RomiFC/RF-DFS/PCB/_dependencies/3dmodels/PMA-183PLN+.stp

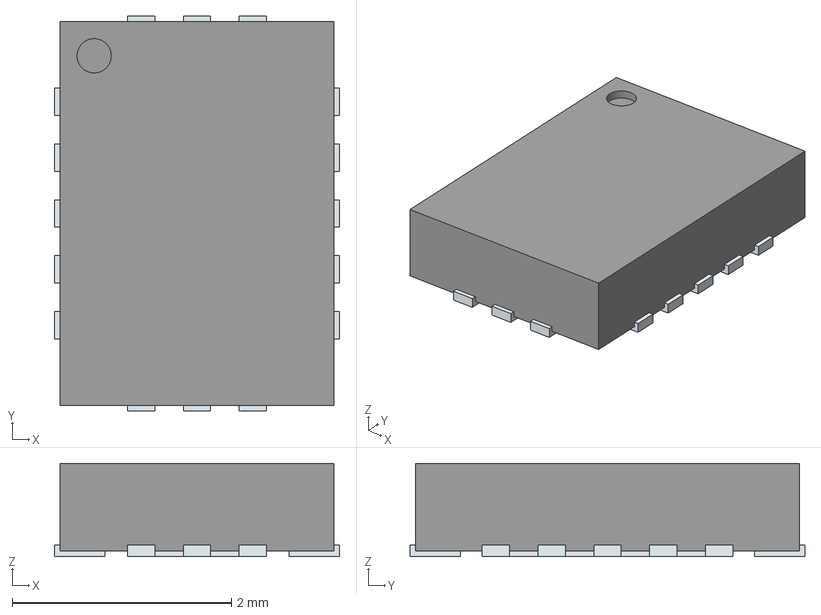
[picture p1: CAD file, 2024-10-30]
PCB/_dependencies/3dmodels/PMA-183PLN+.stp
2.60 x 3.60 x 0.85 mm
ThermalPin
PinsArrayLR
PinsArrayTB
