RomiFC/RF-DFS/PCB/_dependencies/3dmodels/TSS-183A+.stp

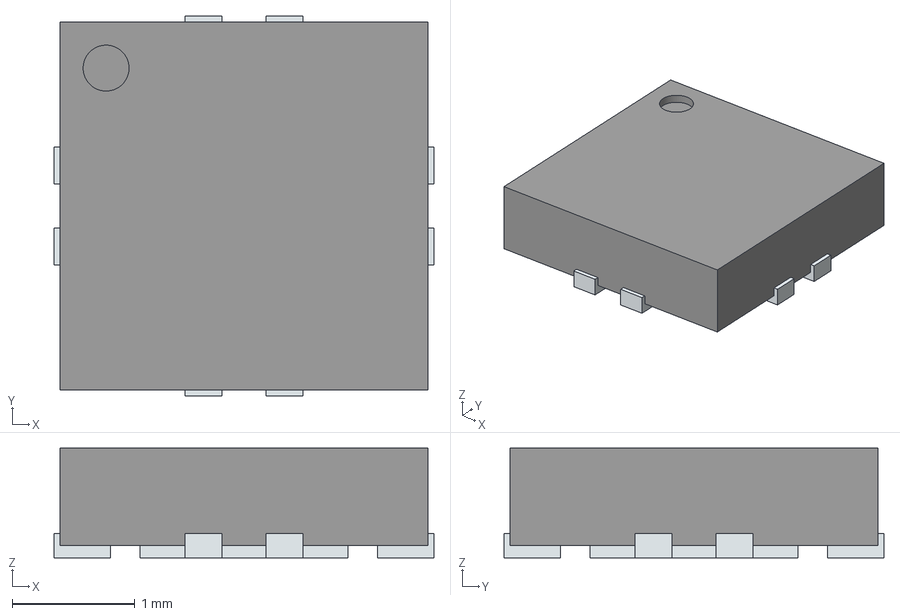
[picture p2: CAD file, 2024-10-30]
PCB/_dependencies/3dmodels/TSS-183A+.stp
3.10 x 3.10 x 0.894 mm
ThermalPin
PinsArrayLR
PinsArrayTB
