RomiFC/RF-DFS/PCB/_dependencies/3dmodels/ADL5902-EVALZ.step

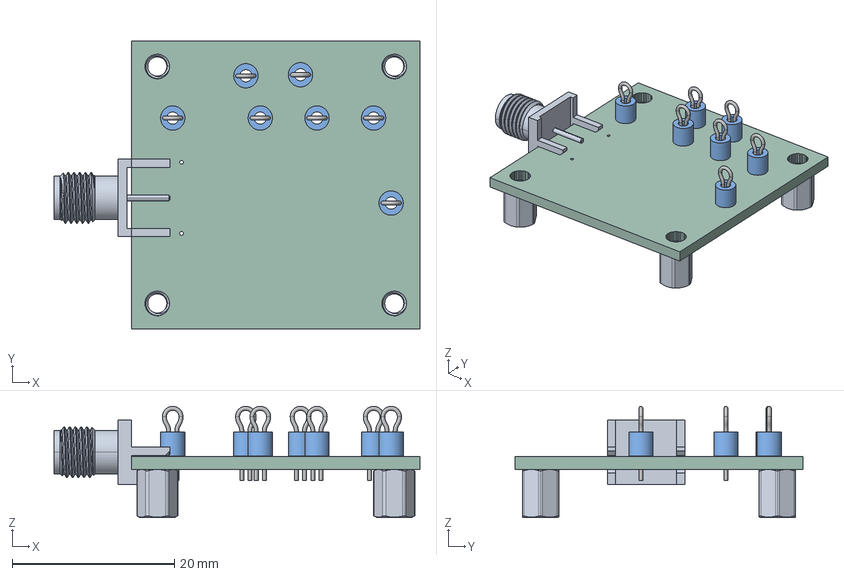
[picture p3: CAD file, 2024-10-30]
PCB/_dependencies/3dmodels/ADL5902-EVALZ.step
45.1 x 35.6 x 13.7 mm
ADL5902-EVALZ PCB
