RomiFC/RF-DFS/PCB/_dependencies/3dmodels/PMA3-14LN+.stp

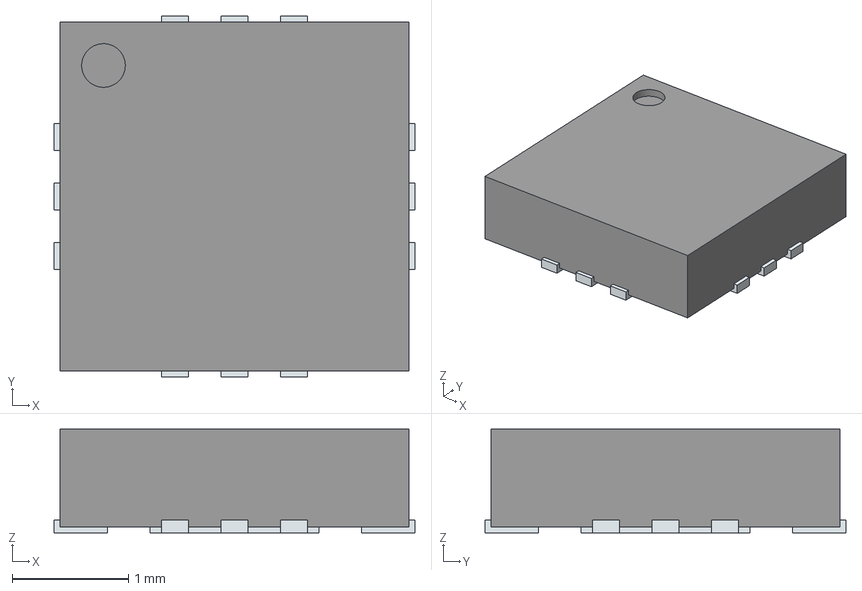
[picture p4: CAD file, 2024-10-30]
PCB/_dependencies/3dmodels/PMA3-14LN+.stp
3.10 x 3.10 x 0.89 mm
ThermalPin
PinsArrayLR
PinsArrayTB
