RomiFC/RF-DFS/PCB/_dependencies/3dmodels/73251-1153.stp

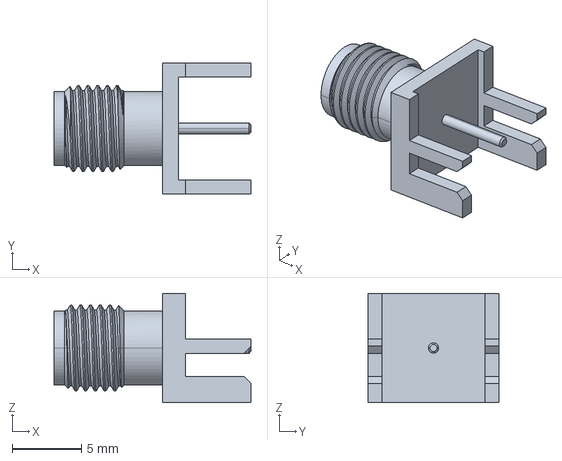
[picture p5: CAD file, 2024-10-30]
PCB/_dependencies/3dmodels/73251-1153.stp
14.3 x 9.53 x 7.92 mm
