RomiFC/RF-DFS/User Guide/README.md

# LaTeX Template

Package fontspec requires XeLaTeX or LuaTeX to compile. If using LaTeX Workshop with VSCode, add `"latex-workshop.latex.recipe.default": "latexmk (xelatex)"` to `workspace.json` or `settings.json`
