RomiFC/RF-DFS/(threads)

Thread 8 (2025-07-18):

Implement trace types

RomiFC, 2025-07-18:
Clear/write is currently the only supported trace type although max hold and average would probably be the most used. This feature should also include the parameters for each trace type (avg count, reset hold, etc.).

Closed 2025-08-06.

Thread 13 (2025-07-19):

Add a method to query spectrum analyzer errors/warnings

RomiFC, 2025-07-19:
An active panel to show errors and warnings like the one on the bottom of the N9040B interface. Some of the errors appear very quickly (ADC overload when the repeater is keyed up) so they need to be queried more often than the SA sweeps.

Thread 14 (2025-07-24):

Add pictures to the user guide

RomiFC, 2025-07-24:
Self explanatory. The ones taken for the DRIFT _about_ page will work fine, also include some pictures of the panels where the electronics are mounted to.

RomiFC, 2025-08-11:
Pictures of the panels can be added at a later date

Thread 18 (2025-08-06):

Streamline single/continuous sweep state machines

RomiFC, 2025-08-06:
Since #17 separates the measurement into INIT and FETCH, :INIT:CONT ON|OFF can be used instead of a Python state machine to keep track of single/continuous sweep states

RomiFC, 2025-08-06:
See also INIT:IMMEDIATE for a _Restart_ button

RomiFC, 2025-08-06:
Should implement a way for single to initiate a sweep if already in single mode (at the moment INIT:CONT 0 does nothing if already in single mode).

Closed 2025-08-06.

Thread 23 (2025-08-11):

Add "Config" section to user guide

RomiFC, 2025-08-11:
Describe `defaultconfig.py` and motor encoder calibration or separate that into another section.

Thread 24 (2025-08-12):

Automation rework

RomiFC, 2025-08-12:
Add an entry widget to the automation queue, allowing users to write python code for each automation thread. More complicated, more potential for things to break, but allows users to do more things.

Need some way to test if a job is active before starting another because if multiple jobs try to access a resource it will surely break things. Also need to disable spectrum analyzer/bearing widgets while the job scheduler is active.

Add some preset job examples for the user to reference in the program.

Closed 2025-08-13.

Thread 26 (2025-08-14):

Consider adding parameter for single/continuous mode

RomiFC, 2025-08-14:
Currently, `analyzerDisplayLoop` attempts to query the spectrum analyzer and populate the front panel in a perpetual `while True:` loop. A problem arises when trying to access the SA front panel because every command will lock it into remote mode.

A benefit of this would be that `analyzerDisplayLoop` could update another widget to display if the device is in single or continuous mode as it would already be querying the local variable before trying to access the resource.

Regardless, Section 3.1 of the documentation needs revision to accurately depict what is happening in `analyzerDisplayLoop`.
