RomiFC/RF-DFS/PCB/PMA3-14LN+/PMA3-14LN+__Assembly.pdf

1 | 2 | 3 | 4 | 5

A

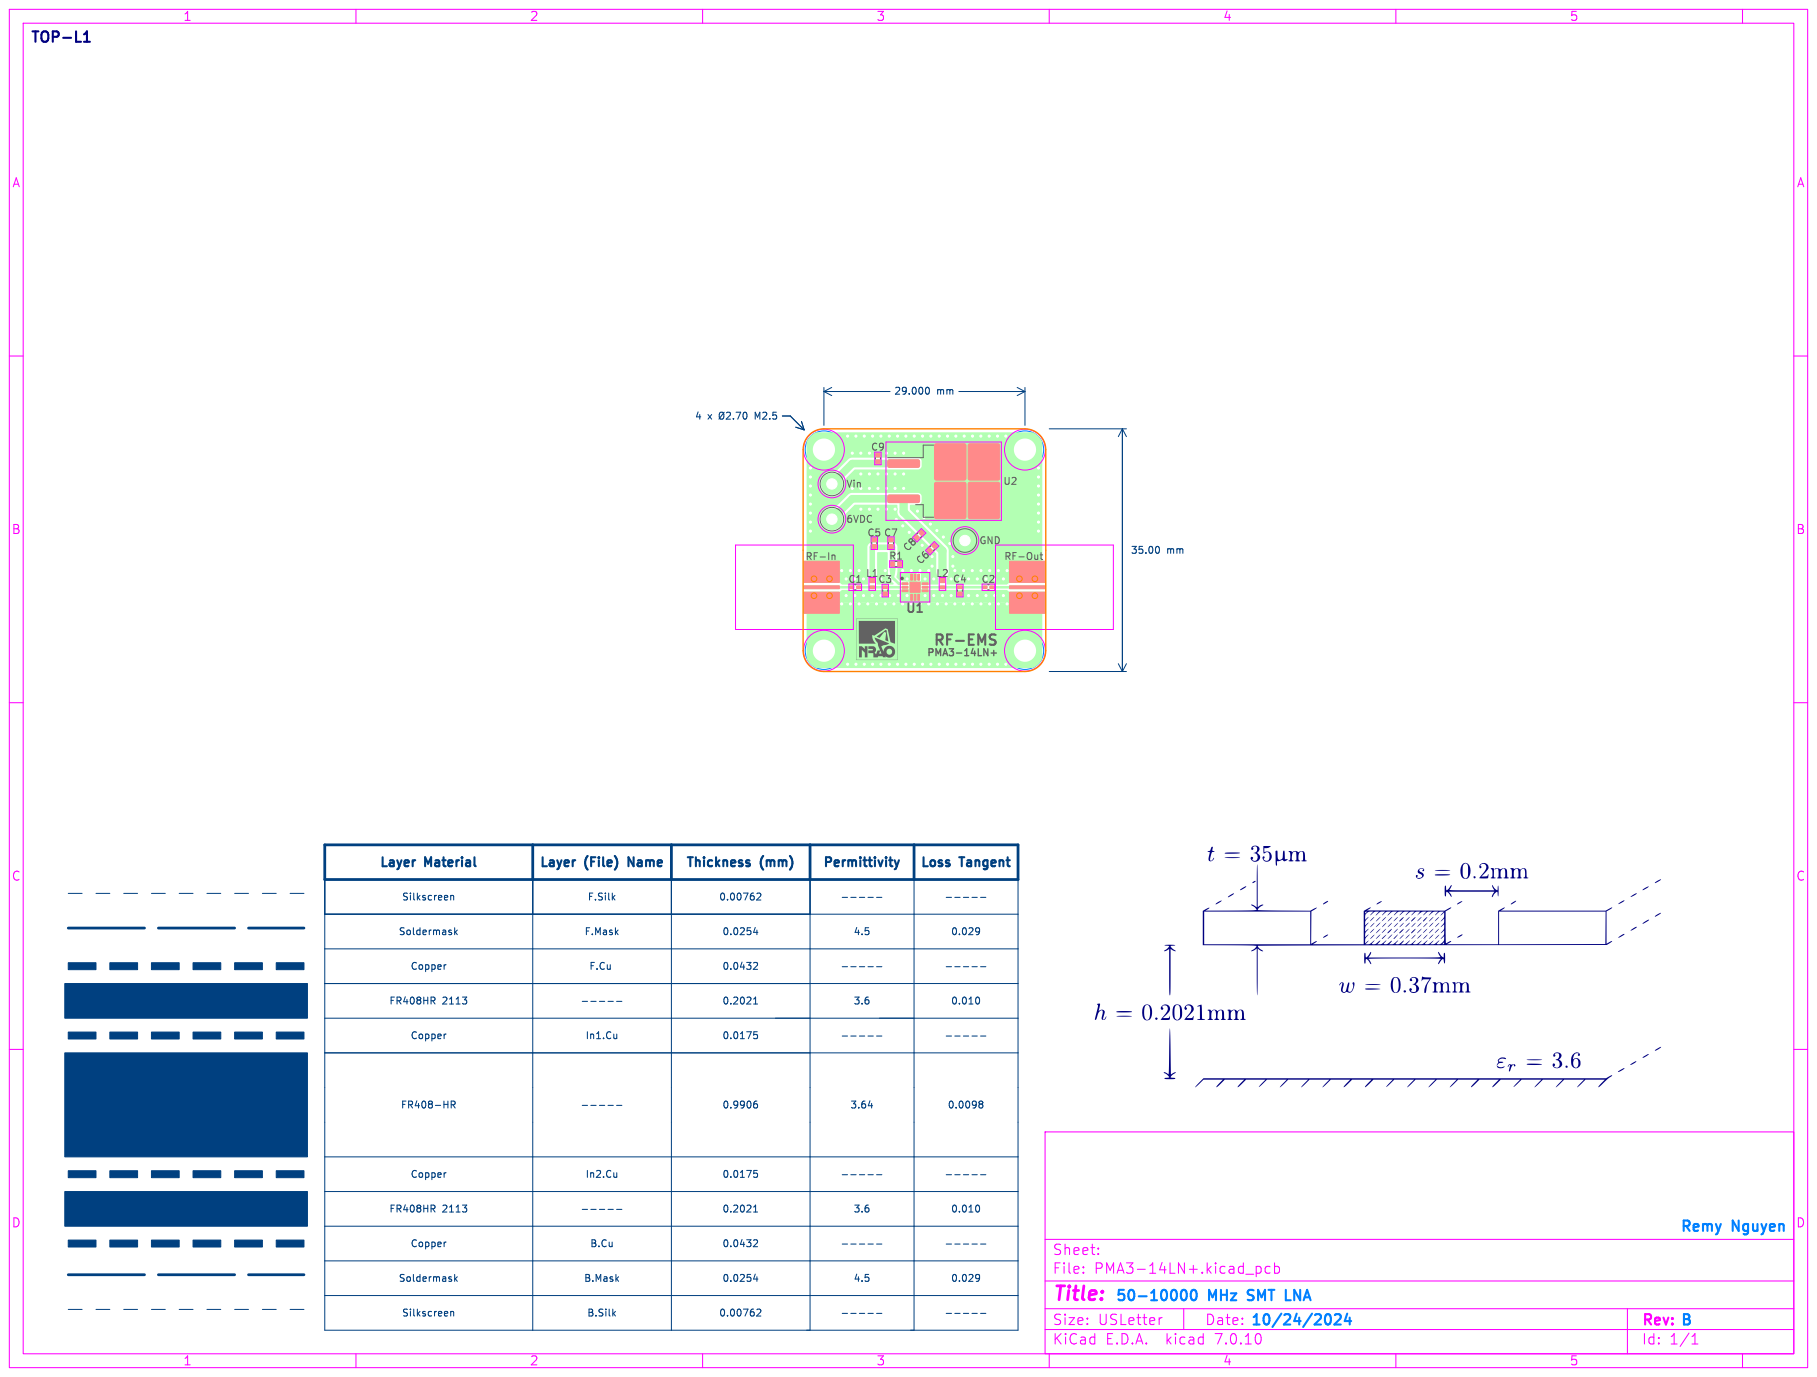
[picture p10: page 1]

Id: 1/1 Title: File: PMA3-14LN+.kicad_pcb Sheet: RF-EMS

A

A

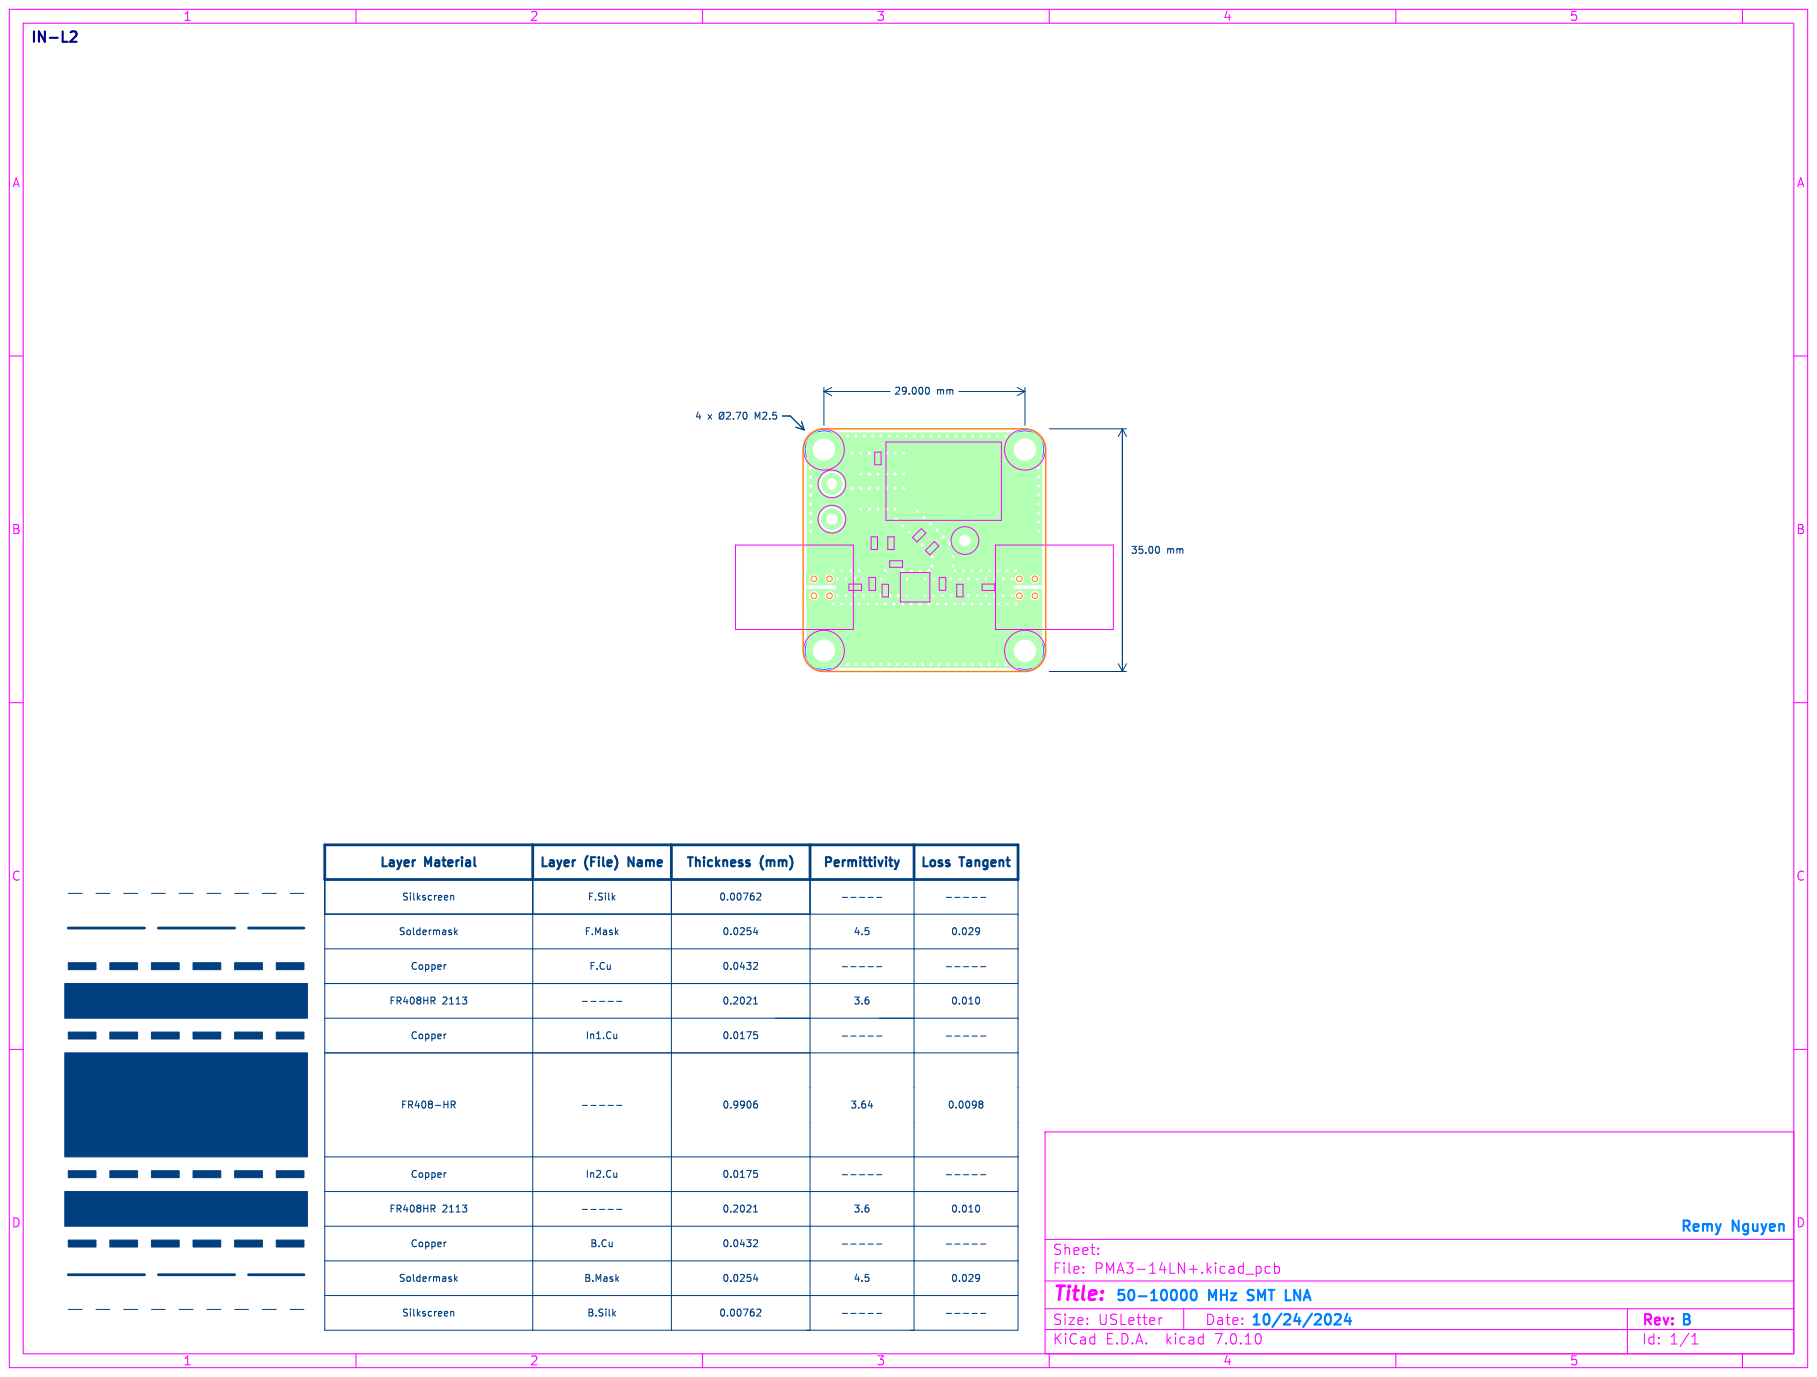
[picture p11: page 2]
Remy; Nguyen; MHz SMT; LNA; D Date: KiCad; kicad; 7.0.10 Size: USLetter; Rev:

-----F.Cu | 0.2021 Layer Material (mm) | Permittivity ----- Thickness ----- | ----- Loss Tangent Copper

Name F.Mask | 0.00762 Copper 0.0175 | ----- Layer (File) ----- F.Silk | 0.010 Soldermask ----- 3.6

Copper | In1.Cu | 0.0175 | ----- Soldermask | ----- Silkscreen FR408HR 2113

---------- | 0.0432 B.Cu 0.0432 FR408-HR | 3.64 ----- Copper | ----- 0.0254 0.0098

In2.Cu | 0.9906 Silkscreen

0.2021 B.Silk | 3.6 B.Mask

Id: 1/1 Title: File: PMA3-14LN+.kicad_pcb Sheet:

A

A

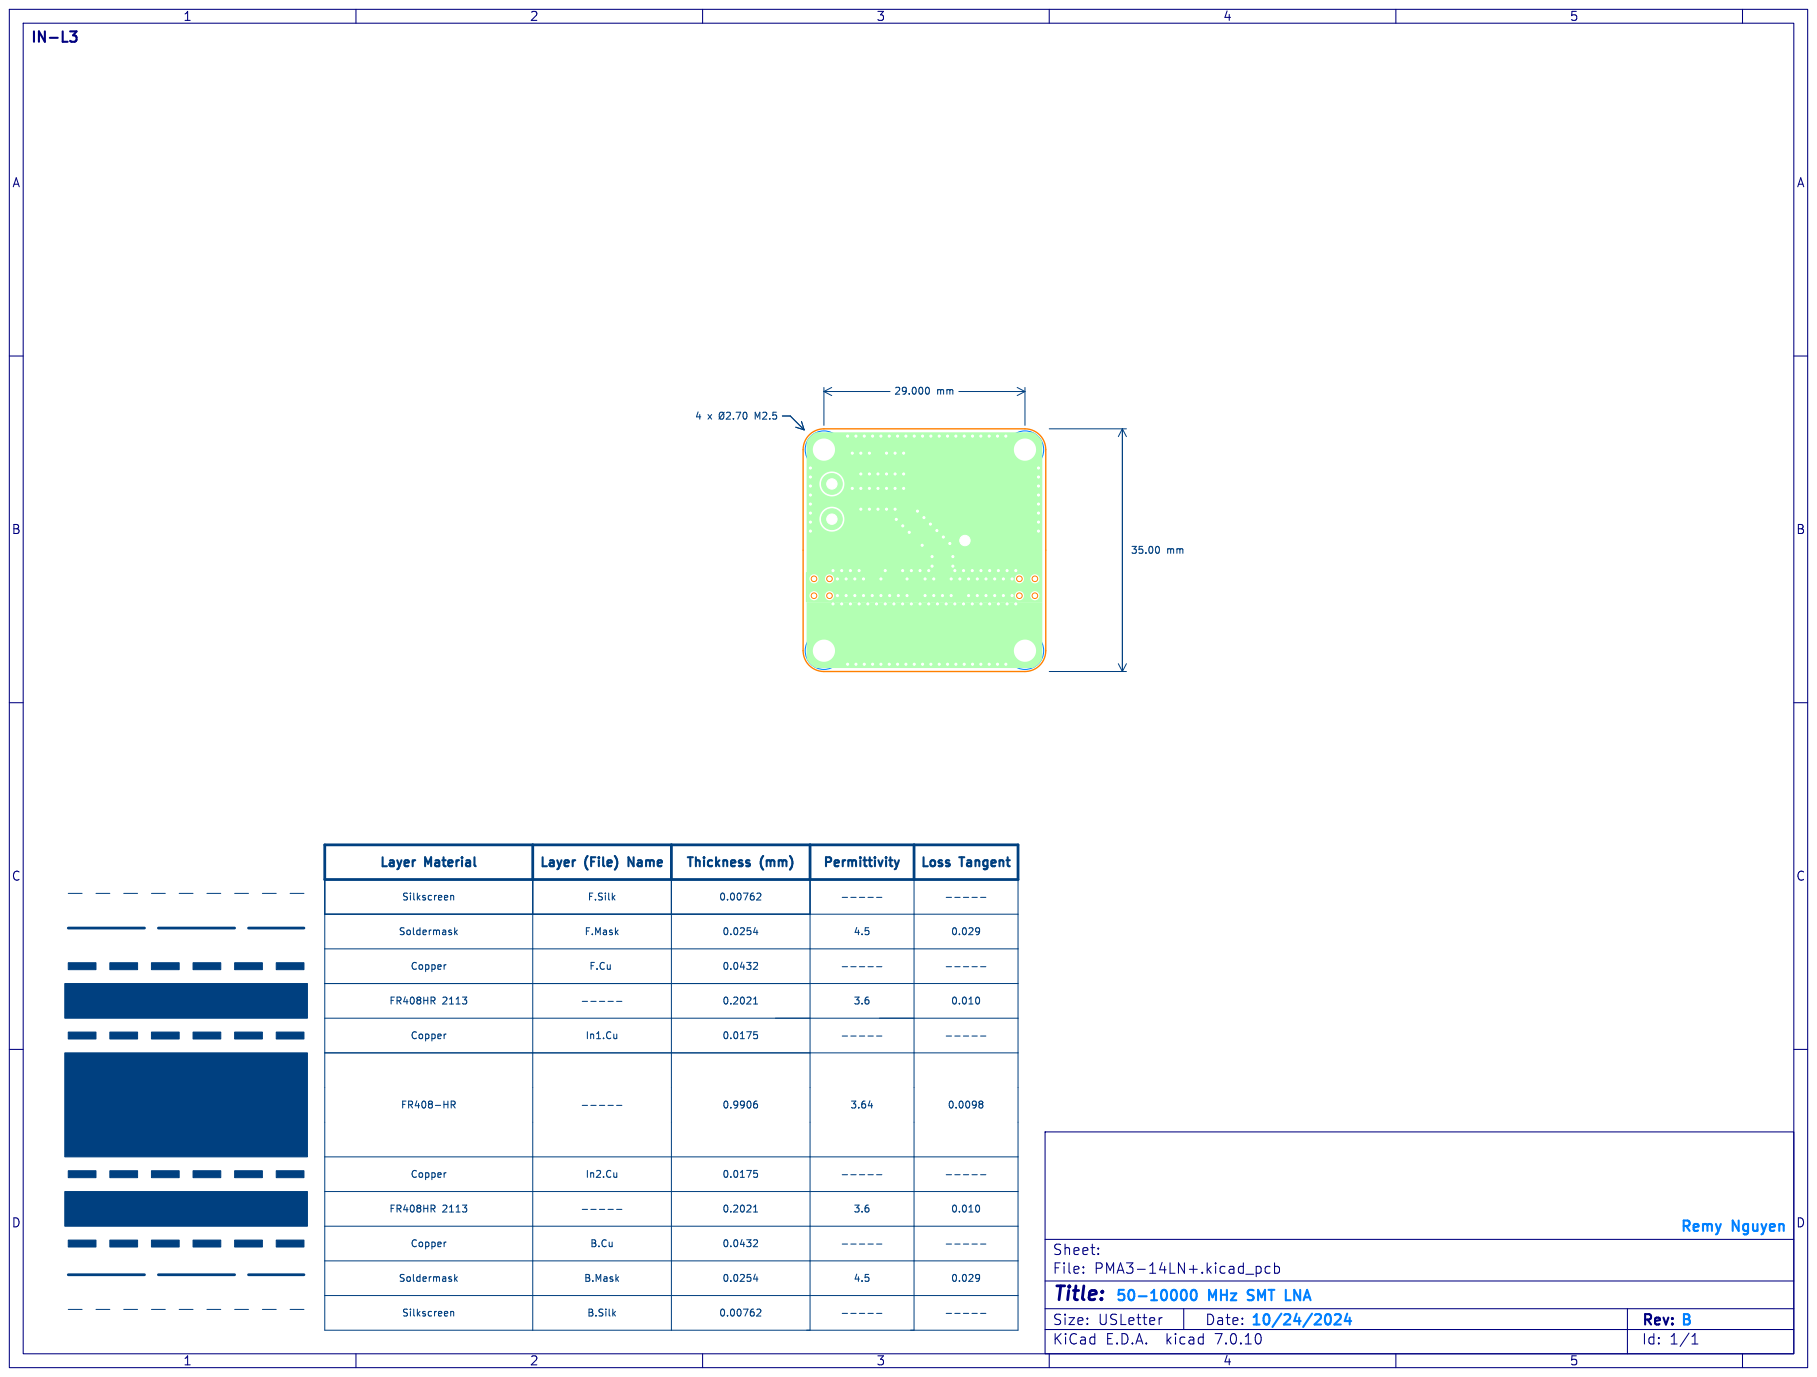
[picture p12: page 3]
Remy; Nguyen; MHz SMT; LNA; D Date: KiCad; kicad; 7.0.10 Size: USLetter; Rev:

-----F.Cu | 0.2021 Layer Material (mm) | Permittivity ----- Thickness ----- | ----- Loss Tangent Copper

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

Copper | In1.Cu | 0.0175 | ----- Soldermask | ----- Silkscreen FR408HR 2113

---------- | 0.0432 B.Cu 0.0432 FR408-HR | 3.64 ----- Copper | ----- 0.0254 0.0098

In2.Cu | 0.9906 Silkscreen

0.2021 B.Silk | 3.6 B.Mask

Id: 1/1 Title: File: PMA3-14LN+.kicad_pcb Sheet:

A

A

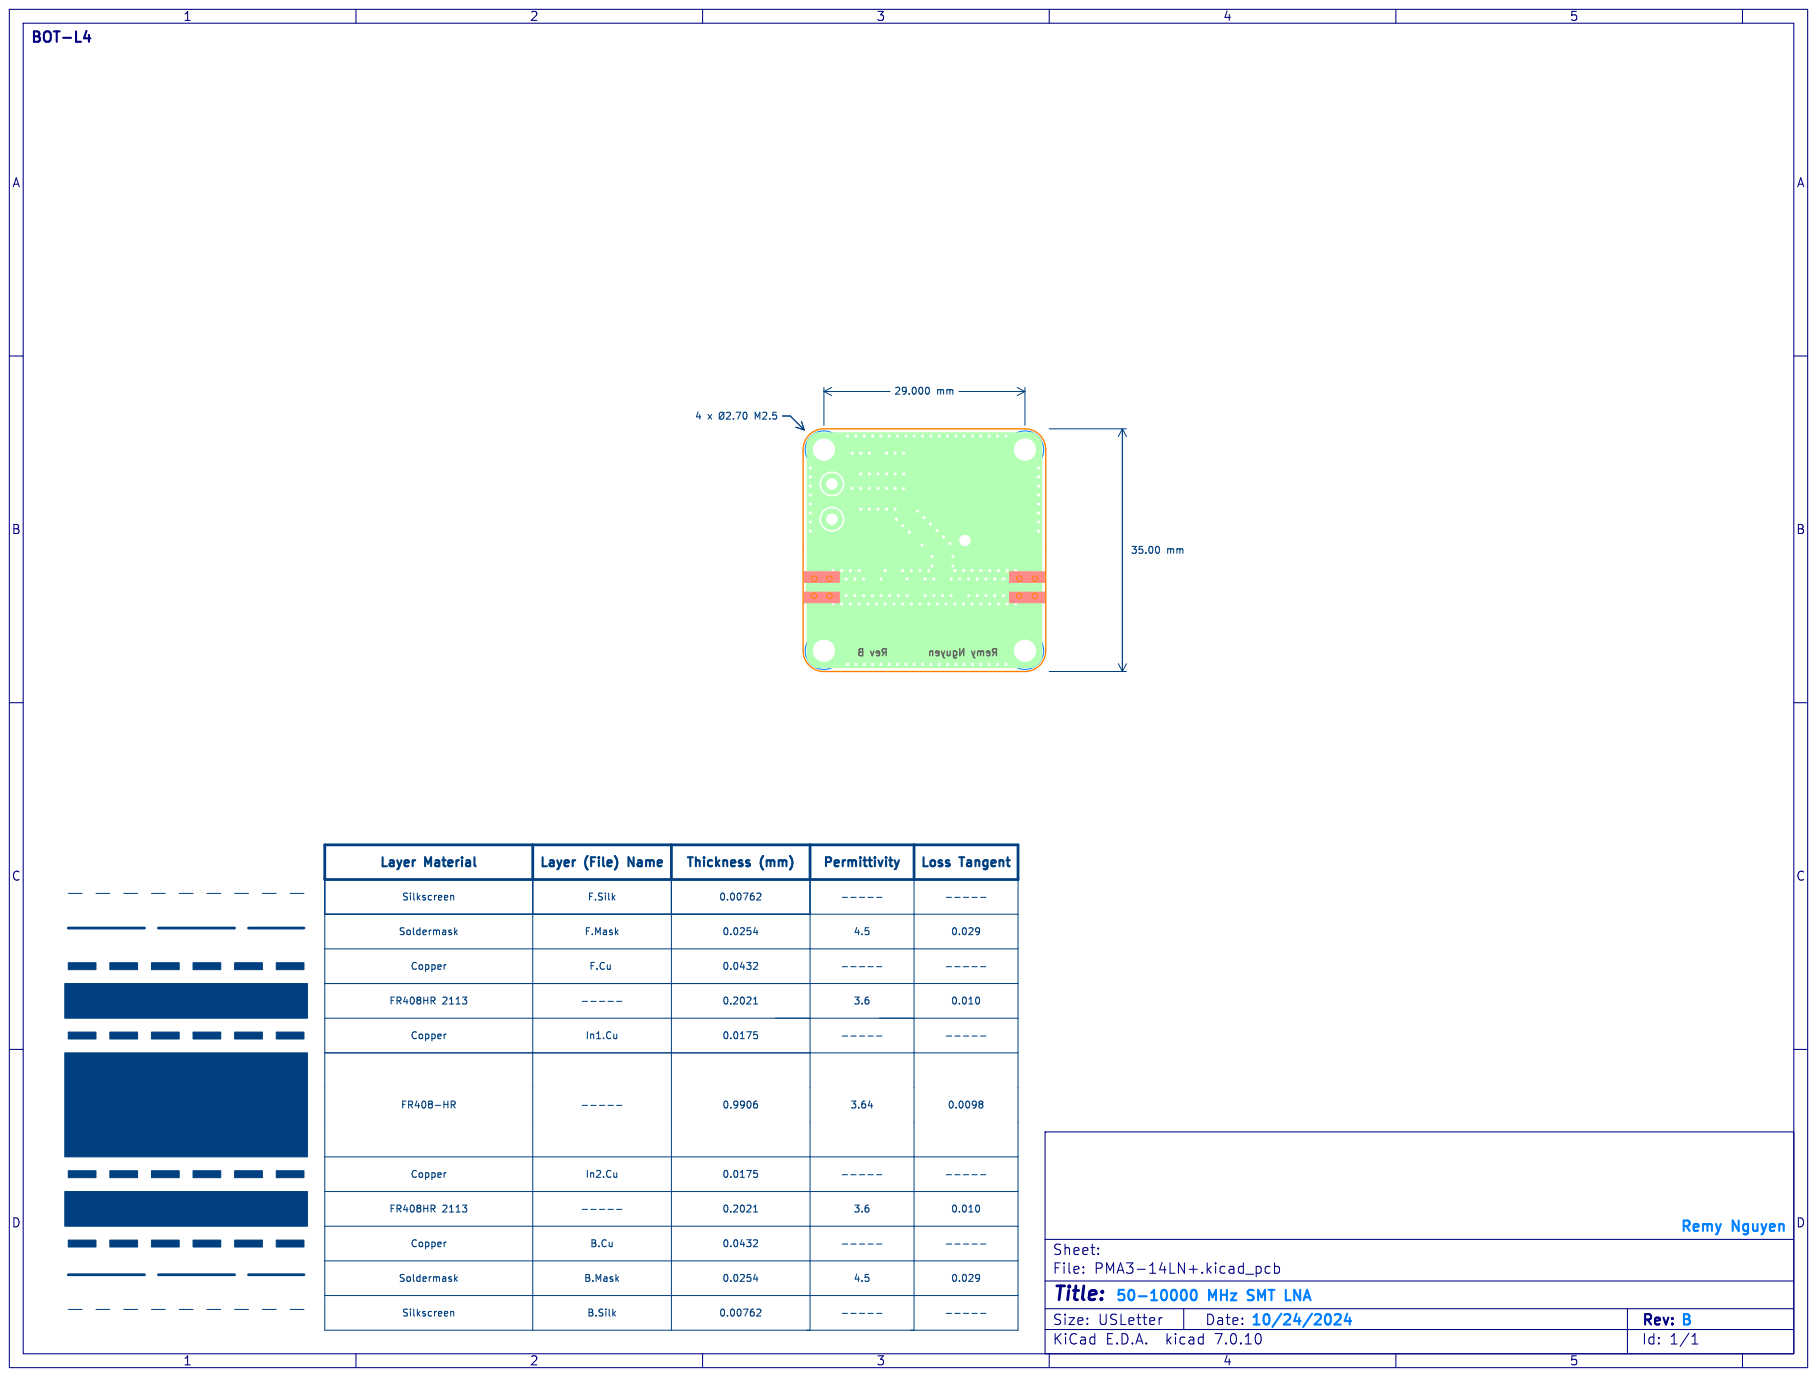
[picture p13: page 4]
Remy; Nguyen; MHz SMT; LNA; D Date: KiCad; kicad; 7.0.10 Size: USLetter; Rev:; BOT-L4

-----F.Cu | 0.2021 Layer Material (mm) | Permittivity ----- Thickness ----- | ----- Loss Tangent Copper

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

Copper | In1.Cu | 0.0175 | ----- Soldermask | ----- Silkscreen FR408HR 2113

---------- | 0.0432 B.Cu 0.0432 FR408-HR | 3.64 ----- Copper | ----- 0.0254 0.0098

In2.Cu | 0.9906 Silkscreen

0.2021 B.Silk | 3.6 B.Mask

Id: 1/1 Title: File: PMA3-14LN+.kicad_pcb Sheet:
