RomiFC/RF-DFS/PCB/PMA-183PLN+/PMA-183PLN+.kicad_pcb

## KiCad design PCB/PMA-183PLN+/PMA-183PLN+.kicad_pcb (2024-10-30)

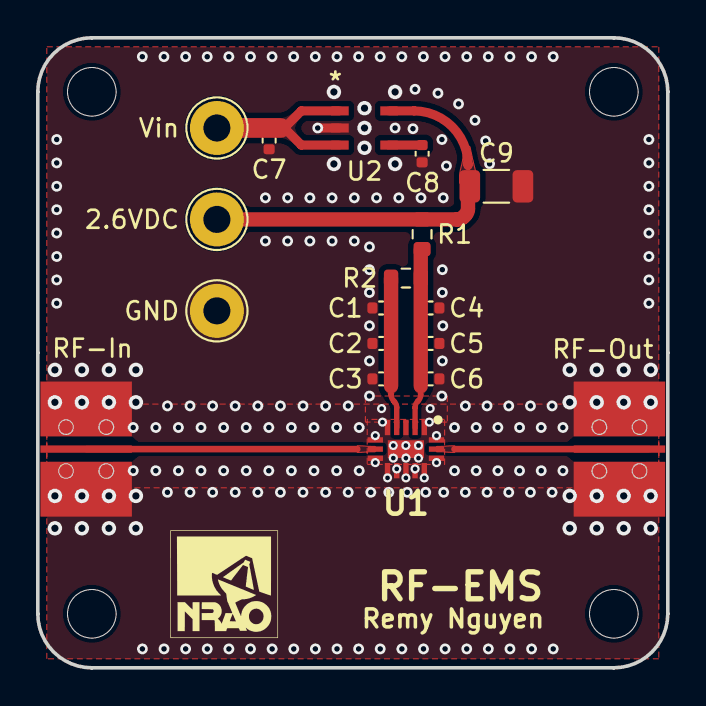
[picture p14: board PMA-183PLN+.kicad_pcb from above]

Board: 4 copper layers, 35.0 x 35.0 mm, 20 parts (0 on the bottom side), 8 nets.

Parts:
2.6VDC: 2.6VDC; TestPoint_Loop_D2.54mm_Drill1.5mm_Beaded
 : FabDrawing-4Layer-Metric-Compact-OSH
 #2: LOGO; GCPW_osh3_90mm_user
C1, C4, C7: 0.33 uF; C_0402_1005Metric
C2, C5: 1000 pF; C_0402_1005Metric
C3, C6: 100 pF; C_0402_1005Metric
C8: 470 pF; C_0402_1005Metric
C9: 2.2 uF; C_1206_3216Metric
GND: GND; TestPoint_Loop_D2.54mm_Drill1.5mm_Beaded
R1: 10 Ω; R_0603_1608Metric
R2: 180 Ω; R_0603_1608Metric
RF-In: Conn_Coaxial; Mueller BU-1420761881
RF-Out: Conn_Coaxial; Mueller BU-1420761881
U1: PMA-183PLN+; QFN51P250X350X85-17N
U2: MIC5219-2.6YM5-TR; SOT-23-5_M5_MCH
Vin: Vin; TestPoint_Loop_D2.54mm_Drill1.5mm_Beaded

Connections:
2.6VDC: 2.6VDC.1, C9.1, R1.2, U2.5 (OUT)
GND: C1.1, C2.1, C3.1, C4.2, C5.2, C6.2, C7.2, C8.2, C9.2, GND.1, RF-In.2 (Ext), RF-Out.2 (Ext), U1.1 (NC_1), U1.3 (NC_2), U1.5 (NC_3), U1.6 (GND_1), U1.8 (GND_2), U1.9 (NC_4), U1.10 (NC_5), U1.11 (NC_6), U1.12 (NC_7), U1.13 (NC_8), U1.14 (GND_3), U1.16 (GND_4), U1.17 (EP), U2.2 (GND)
unnamed: RF-In.1 (In), U1.7 (RF-IN)
unnamed: RF-Out.1 (In), U1.15 (RF-OUT)
unnamed: C4.1, C5.1, C6.1, R1.1, R2.2, U1.2 (VDD)
unnamed: C1.2, C2.2, C3.2, R2.1, U1.4 (VE)
unnamed: C8.1, U2.4 (BYP)
Vin: C7.1, U2.1 (IN), U2.3 (EN), Vin.1
