RomiFC/RF-DFS/PCB/PMA3-14LN+/PMA3-14LN+.kicad_pcb

## KiCad design PCB/PMA3-14LN+/PMA3-14LN+.kicad_pcb (2024-10-30)

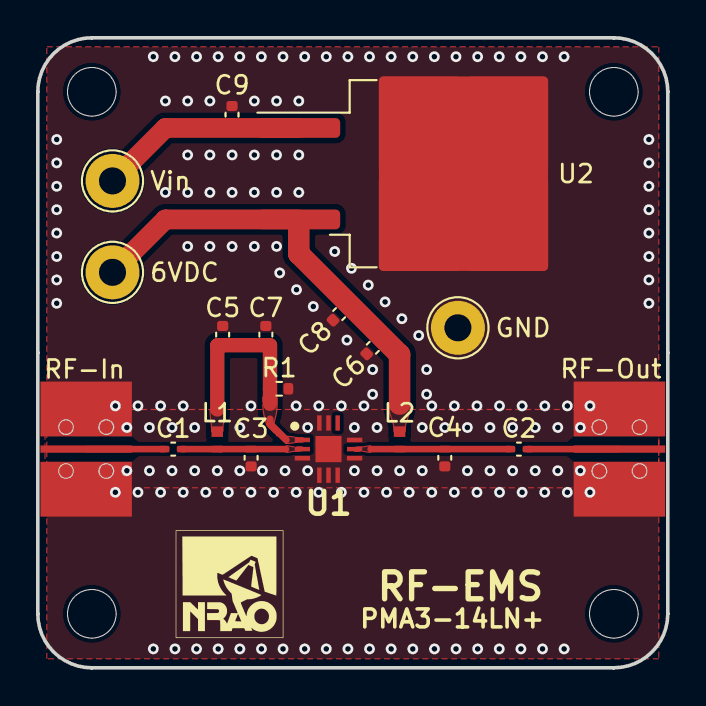
[picture p15: board PMA3-14LN+.kicad_pcb from above]

Board: 4 copper layers, 35.0 x 35.0 mm, 20 parts (0 on the bottom side), 8 nets.

Parts:
6VDC: 6VDC; TestPoint_Loop_D2.54mm_Drill1.5mm_Beaded
 : FabDrawing-4Layer-Metric-Compact-OSH
C1, C2: 0.01 uF; C_0402_1005Metric
C3: 0.2 pF; C_0402_1005Metric
C4: 0.1 pF; C_0402_1005Metric
C5, C6: 100 pF; C_0402_1005Metric
C7: 0.1 uF; C_0402_1005Metric
C8: 0.1 uf; C_0402_1005Metric
C9: 0.33 uF; C_0402_1005Metric
GND: GND; TestPoint_Loop_D2.54mm_Drill1.5mm_Beaded
L1, L2: 900 nH; L_0402_1005Metric
R1: 510 Ω; R_0402_1005Metric
RF-In: Conn_Coaxial; Mueller BU-1420761881-RevB
RF-Out: Conn_Coaxial; Mueller BU-1420761881-RevB
U1: PMA3-14LN+; QFN51P300X300X89-13N
U2: L7806; TO-263-2
Vin: Vin; TestPoint_Loop_D2.54mm_Drill1.5mm_Beaded

Connections:
6VDC: 6VDC.1, C6.1, C8.1, L2.1, U2.3 (OUT)
GND: C3.1, C4.1, C5.1, C6.2, C7.1, C8.2, C9.2, GND.1, R1.2, RF-In.2 (Ext), RF-Out.2 (Ext), U1.3 (NC_1), U1.4 (NC_2), U1.5 (NC_3), U1.6 (NC_4), U1.7 (NC_5), U1.9 (NC_6), U1.11 (NC_8), U1.12 (NC_9), U1.13 (GND), U2.2 (GND)
unnamed: C5.2, C7.2, L1.1, R1.1, U1.1 (CURRENT_MIRROR)
unnamed: C1.2, C3.2, L1.2, U1.2 (RF-IN)
unnamed: C2.1, C4.2, L2.2, U1.8 (RF-OUT_&_VDD)
unnamed: C1.1, RF-In.1 (In)
unnamed: C2.2, RF-Out.1 (In)
Vin: C9.1, U2.1 (IN), Vin.1
