RomiFC/RF-DFS/(commit log)

2024-08-06 PLC code added with basic functionality
    - Successfully receives and parses strings from serial into opcodes.
    - Needs additional functionality/opcodes for configuration and error messaging
    [main.cpp]
2024-08-12 Added placeholder widgets to analyzer frame in gui
2024-08-20 Multiple changes to GUI
    - Moved class FrontEnd variables/constants to __init__
    - Moved Vi object of class VisaControl to __init__
    - Added timestamp.py which prepends print call with a timestamp
    * @file opcodes.py
    * @author Remy Nguyen (rnguyen@nrao.edu)
    * @brief Header file that contains opcode declarations for the P1AM-100 PLC.
    *
    * Each opcode is an 8-bit binary number with the following syntax:
    * - Leading 1
    * - 1 for selection operation
    * - 2-bit antenna selection code (00 for EMS, 01 for DFS)
    * - 4-bit RF chain selection code
    *
    * OR
    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
2024-08-21 Moved class FrontEnd from functions.py to main.py to prevent circular import when multithreading
    [main.py]
2024-08-22 Embedded matplotlib plot to gui which tracks analyzer trace
2024-08-26 Changes to gui-dev spectrum analyzer plot
    - initAnalyzerDisplay() ==> loopAnalyzerDisplay() which should not
    return for the duration of thread t1's life
    - toggleAnalyzerDisplay() now only sets analyzerKillFlag and does not
    interact with threading at all
2024-08-29 Entry widgets validate on keypress, console scrolls to bottom when new message is inserted
2024-08-29 Additions to gui-dev analyzer widgets
    - New function clearAndSetEntry(widget, arg) deletes all values in widget and
    replaces it with arg
    - Spectrum analyzer plot ttk::Entry widgets bound to
    FrontEnd.setAnalyzerValue() on <Return>
    - Function isNumber now tests for scientific notation and decimals
    - FrontEnd.setAnalyzerValue() tested successfully with centerfreq
    parameter
    [main.py]
2024-08-29 FrontEnd.resetWidgetValues() changed to FrontEnd.resetConfigWidgets()
    [main.py]
2024-08-30 Deleted cached kicad files
    [Bill of Materials.csv, PMA3-14LN+.sch]
2024-08-30 Changes to gui analyzer display and multithreaded visa communications
    - setAnalyzerValues not instantiates a list of dictionaries based on
    kwargs, then iterates through the list to issue visa commands (Reduces
    lines of code in each if statement)
    - New threading events AllowAnalyzer and isAnalyzerActive to allow main
    thread and t1 to communicate. main thread will wait for t1's display
    loop to end when setAnalyzerValue is called and set AllowAnalyzer to
    FALSE before continuing. This will prevent a thread from issuing a
    viWrite after the other thread issues a viQuery and before it can
    issue a viRead (Fatal error)
    [main.py]
2024-09-03 Fixed fatal bug where calls to setAnalyzerValue would interrupt :READ:SAN?
    - setAnalyzerValue moved to analyzerThreadHandler which creates an
    independent thread. This thread acquires a lock so that only one
    function can issue VISA commands at a time.
    - loopAnalyzerDisplay sets and acquires lock between sleep time
    - Issue persists where an out of range VISA command creates a fatal
    error (such as stop frequency > 52 GHz).
    [main.py]
2024-09-04 Spec-an widgets now synchronize on device connection
    - Function clearAndSetEntry now attempts to convert arg to scientific notation before passing it to widget
    - Print calls changed to logging.info/warning/error for thread safety
    - Value None can now be passed to a kwarg in setAnalyzerValue to synchronize widget without writing a value to the spec-an
    [main.py]
2024-09-05 Minor changes to gui
    - Plot axes have title and labels
    - Moved instantiation of `DFS_Window` after `console` so that logging
    functions in __init__ are placed in the console window
    - Moved resetAnalyzerState to frontendio.py
    - Changed print calls in frontendio.py to logging
    [frontendio.py, main.py]
2024-09-06 Included pcb libraries in repository under '_dependencies' with projects linked to them using relative paths
    [002.35.20.15.20-001-PCB-Biasing.kicad_sch, 002.35.20.15.20-001-PCB-LNA.kicad_sch, 73251-1153.stp, ADL5902-EVALZ.step, PMA-183PLN+.kicad_pcb, PMA-183PLN+.kicad_sch, PMA-183PLN+.stp, PMA3-14LN+.kicad_sch]
2024-09-12 Spectrum Analyzer plot now automatically sets limits
    - Moved initAnalyzerPlotLimits functionality to setAnalyzerPlotLimits
    - Removed method initAnalyzerPlotLimits
    - setAnalyzerPlotLimits gets parameters from widgets instead of visa
    queries to reduce thread locking and redundant visa queries.
    - setAnalyzerValue initializes arg:None for keys which may influence
    plot limits, then calls setAnalyzerPlotLimits in case a visa write
    changed parameters other than the explicitly written parameter.
2024-09-12 Added auto/manual radiobutton functionality
    - Bug persists where radiobuttons do not update entries
    [main.py]
2024-09-13 Fixed bug where exception is not logged in loopAnalyzerDisplay
    [main.py]
2024-09-17 Theme additions
    - Moved motor port selection to config tab, added plc port selection to config
    tab.
    - Added ttk theme to root window
    - Changed combobox highlight color to match regular colors to prevent
    blue highlight whenever an option is selected (does not work in
    readonly state)
    - Removed connect button from instrSelectBox, now all port connection
    boxes call their respective function on <<ComboboxSelected>>
    [main.py]
2024-10-10 loopAnalyzerDisplay now checks Operation Status before beginning sweep
    - New methods getEventRegister, getOperationRegister, and
    getCalCondRegister in class VisaControl.
    - Added single sweep button.
2024-10-10 Removed control/config tabs in favor of menubar organization. resetConfigwidgets() is now deprecated
    [frontendio.py, main.py]
2024-10-11 Started moving azimuth and elevation entries to class AziElePlot
    - Still needs work to save motor port in variable instead of getting
    from widget motorSelectBox (It only exists when 'Configure...' menu is
    open"
2024-10-14 Added logging level TERMINAL
    - Added docstring to setAnalyzerValue and fixed combobox not setting
    default arg to None
    - Moved tkVars to class SpecAn from class FrontEnd
    [main.py]
2024-10-14 Implemented trace and log saving
2024-10-15 New control and status widgets
    - Changed root geometry manager from pack to grid
    - New method FrontEnd.setStatus for buttons being used as status
    indicators
2024-10-17 Added class PLCIO in frontendio.py:
    - Contains methods for Serial communications (For PLC but can be reused
    for general serial communications). Contains it's own thread handler
    and lock as opposed to VisaIO, where threading and locking is handled
    outside of the class.
    - OpCode sending and receiving tested successfully.
2024-10-17 Added PLC operation buttons to front end (kind of, needs work)
2024-10-22 Fixed bug where opcodes were not sent with newline characters, causing them to be appended with uncleared characters from previous inputs.
    - The bug which appends opcodes occurs in the PLC code, where parsed
    inputs are being appended with extra characters. This bug persists
    although the addition of a newline character in each write prevents
    the PLC code from continuing to parse characters.
    [frontendio.py, opcodes.py]
2024-10-22 Fixed bug where serial query delay was not working as intended and added longer delay to P1_INIT/P1_DISABLE commands
    [frontendio.py, main.py]
2024-10-22 Changed plcOperationStateMachine case statements from shorthand string to opcodes, removed some visa error handling that resulted in extraneous printing
    [main.py]
2024-10-24 PMA3-14LN+ Rev B Complete
    [PMA3-14LN+.kicad_pcb, PMA3-14LN+.kicad_sch]
2024-10-24 Fixed board clearance in PMA3 -14LN+
    [PMA3-14LN+.kicad_pcb]
2024-10-28 Class PLCIO renamed to SerialIO (will likely be used for motor as well)
2024-10-30 Added save trace as csv functionality
2024-10-30 PLC now keeps track of status (output conditions) and can be queried for status
2024-10-30 Front end now updates PLC state
    - New thread statusMonitorPLC which constantly monitors the attribute
    SerialIO.status for changes.
    - SerialIO.write now has the argument getStatus to determine whether or
    not to send a opcodes.QUERY_STATUS message 1.2 seconds after the
    original message. This delay is required but may be fixable in the
    PLC code.
    - Removed plcOperationStateMachine and moved its functionality to
    statusMonitorPLC.
    [frontendio.py, main.py, opcodes.py]
2024-11-01 PLC no longer returns query opcode
    [main.cpp]
2024-11-01 Added disconnect buttons to resources in config menu
2024-11-19 Added y axis unit to amp tab of spec an controls
2025-02-04 Added config.toml implementation including:
    - Error checking for missing config or keys
    - Method for loading default config on error
    - Method for generating default config file in case of corruption.
    [defaultconfig.py, main.py]
2025-02-10 Spec_An.loopAnalyzerDisplay changed to finite state machine
    - New functions disableChildren() and enableChildren() for tkinter
    frames
    - New method Spec_An.toggleInputs() to utilize previous functions
    - Spectrum plots now enable and disable based on thread state
2025-02-10 Fixed spectrum widget sizing
    [main.py]
2025-02-10 Added write/read/query methods to MotorIO because the preexisting methods are overly convoluted and I don't want to break things yet
2025-02-10 Added threading.RLock to MotorIO serial calls
2025-02-11 Added logging level MOTOR to write/read/query methods of class MotorIO
2025-02-11 Partially implemented az/el state machine (UNTESTED)
    - Added exception type to error logging.
    - Added drive status to status monitor thread
    [frontendio.py, main.py]
2025-02-11 Bound frontend buttons to change aziele state machine condition
2025-02-12 Motor encoder counts successfully parsed from program, still needs implementation
2025-02-13 Fixed some window resizing bugs
    [main.py]
2025-02-13 Updated defaultconfig.py with (uncalibrated) encoder values
2025-02-13 Changed AziElePlot.sendMoveCommand to simple Motor.write call
2025-02-13 Motor motion commands implemented
2025-02-14 Motor command angle changed to last command
2025-02-14 Fixed polar title intersecting with labels
    [main.py]
2025-03-20 Changed thread names for consistency
2025-04-30 doc: added switches to sysblock2
2025-05-01 doc: rf signal chain and hig changes
2025-05-02 doc: wiring diagram fixed jfc
2025-05-02 doc: added the other wiring diagram and some sug stuff
2025-05-02 doc: more wiring
2025-05-05 doc: another block diagram and fixed some wiring stuff
2025-05-05 doc: shack components section and ems power wiring diagram
2025-05-08 doc: motor position and opcodes
2025-05-09 doc: idek a bunch of wiring diagrams ig
2025-05-30 gui: added header to saved traces
2025-06-05 gui: added trace type parameter
2025-06-05 gui: cleanup and added halt movement & kill drives buttons (untested)
